saurabh-wandhekar/Door-Security-Control/README.md

# Door-Security-Control
8086-microprocessor based system to control opening and closing of a door on password entry.
