saurabh-wandhekar/Door-Security-Control/design.pdf

### DESIGN IN MULTIPLE PARTS

1. 8086,8284,latches and transceivers:

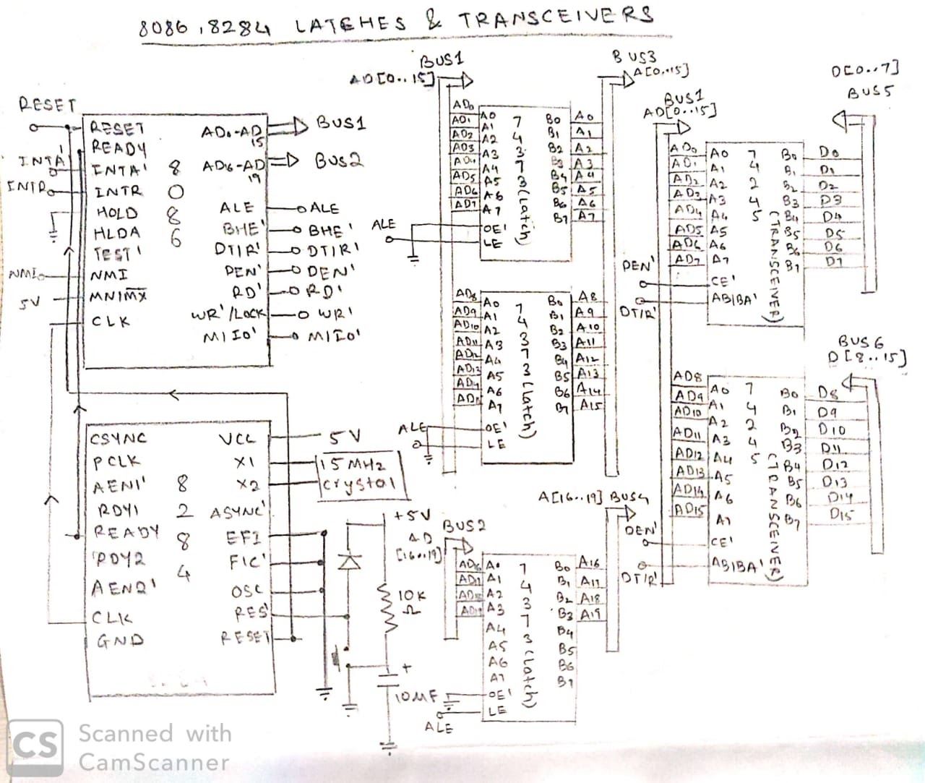
[picture p1: figure]

2. Memory Interfacing

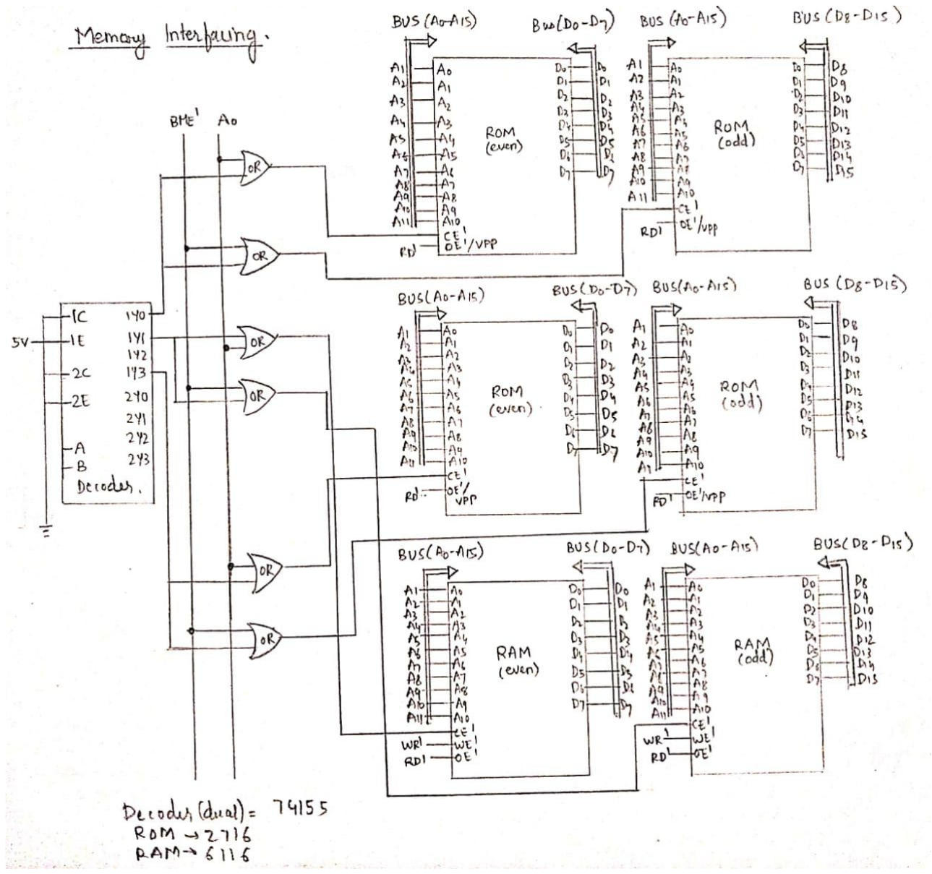
[picture p2: figure]

3. 8255-1 with Hexpad and LCD Display

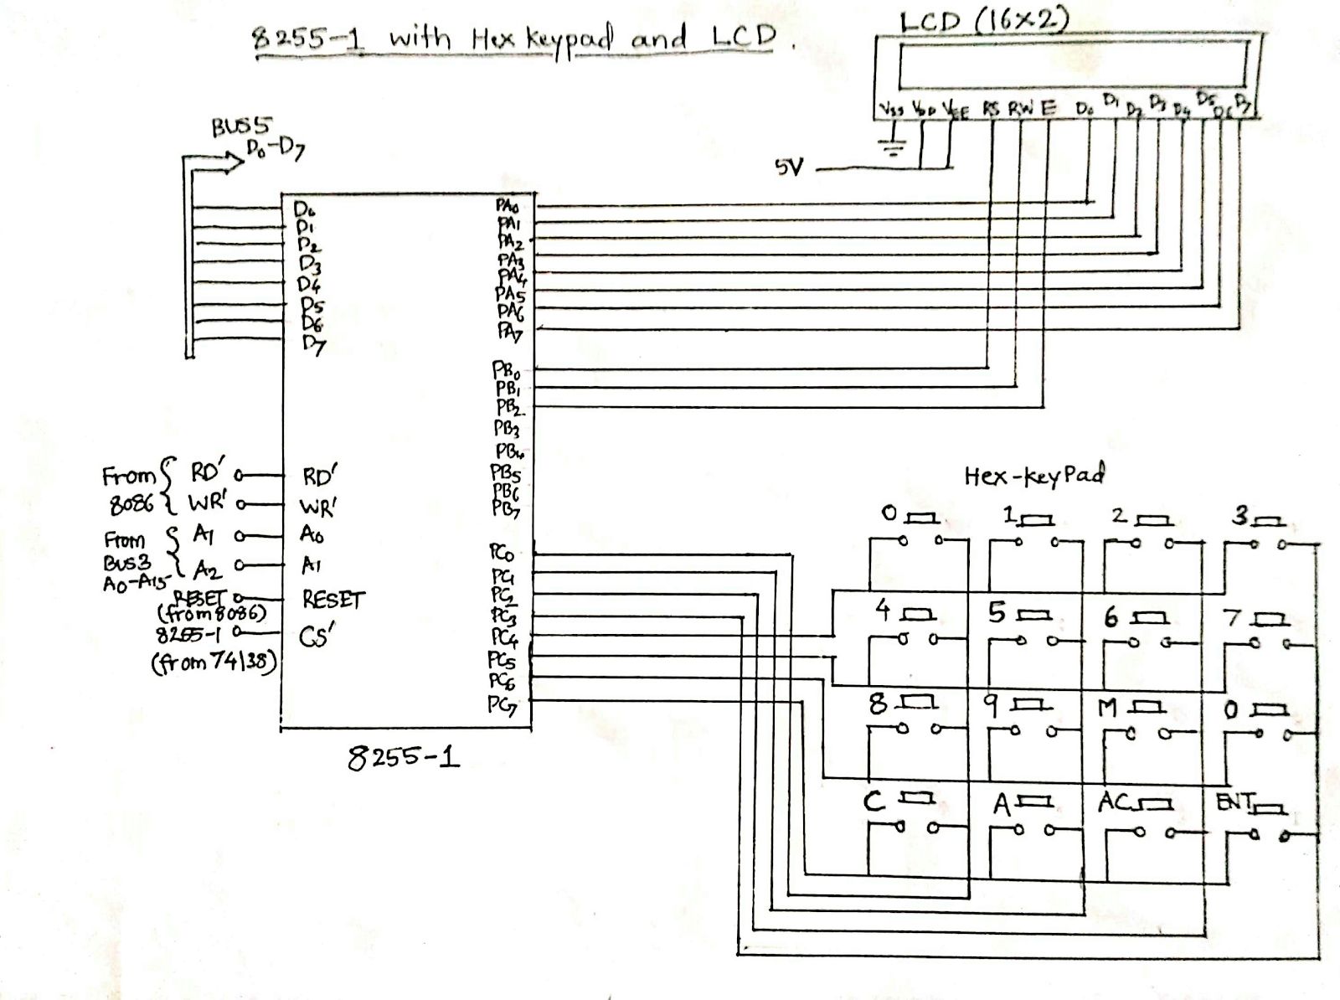
[picture p3: figure]

4. 8255-2 with Darlington pair, Motor, LEDs, Alarm and Relay

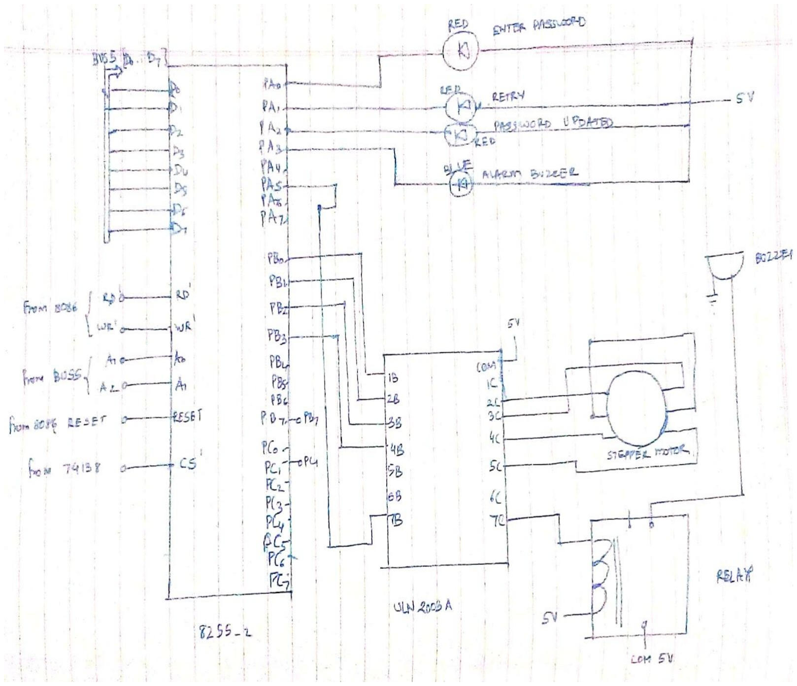
[picture p4: figure]

5. Decoding circuit with 8253-1 and 8253-2

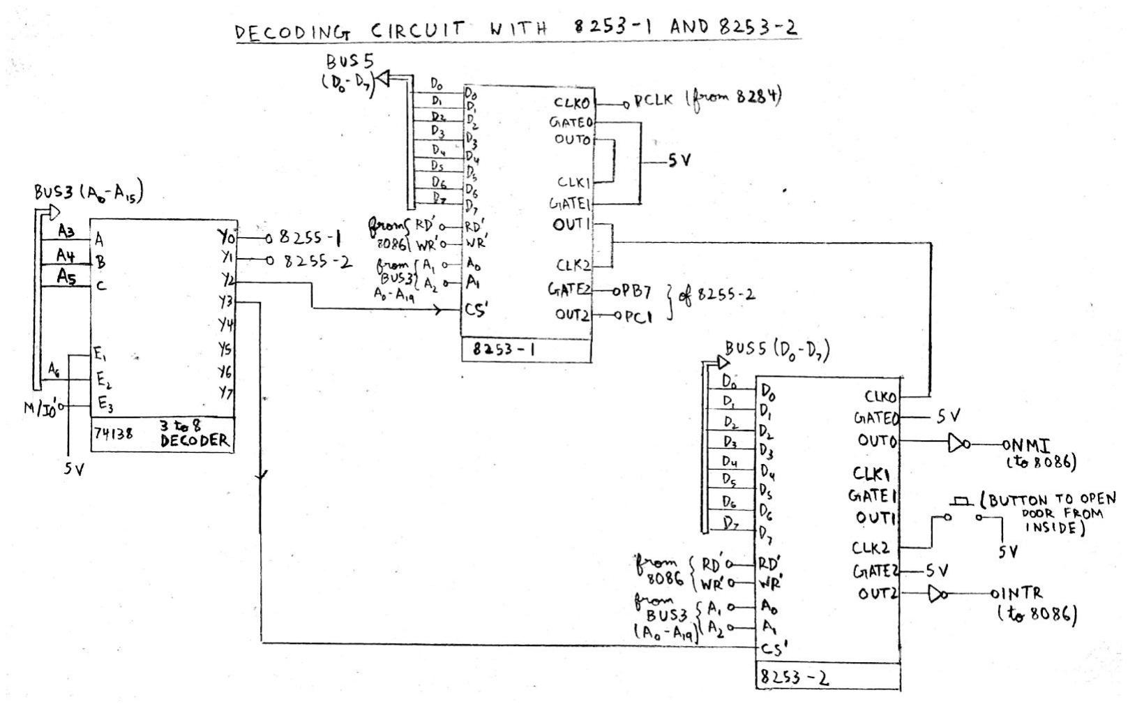
[picture p5: figure]

6.Tristate Buffer for Interrupt

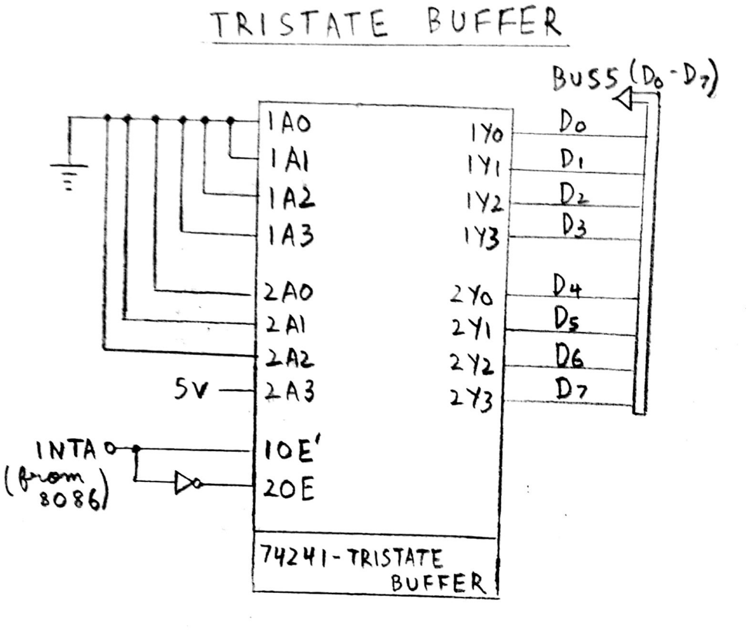
[picture p6: figure]
