saurabh-wandhekar/Door-Security-Control/(list of files, drawings)

Other design files:
G45.DSN
